jtof-dev/robotics-traveling-van-ipr/documents/RTV_Description.pdf

Project Description: The Robotics Traveling Van project focuses on designing and building two low-cost, portable educational robots that demonstrate core control system concepts for K-12 outreach. Sponsored by Dr. Michael Shafer at Northern Arizona University, the project aims to create safe, highly durable, and visually engaging platforms that help students connect physical robot kinematics to abstract ideas like feedback loops, stability, and actuation. The team is developing two integrated systems: Robot 1, an inverted pendulum robot designed to maintain dynamic balance while students physically interact with it, and Robot 2, a ball-balancing platform that utilizes a center-pivot ball-on-beam architecture. Both robots are engineered specifically for a pilot-run manufacturing scale, ensuring they are classroom-friendly, robust enough to survive repeated physical demonstrations, and visually professional.

Approach: The project utilizes a rigorous engineering design process, translating customer needs into strict engineering requirements through House of Quality matrices, benchmarking, and functional decompositions. To bridge the gap between mechanical hardware and electrical control, the team focused heavily on Design for Manufacturability (DFM) and Design for Assembly (DFA).For Robot 1, the team modeled the inverted pendulum dynamics to design a highly resilient frame capable of surviving classroom drop tests, creating a stable physical baseline for the state space and PID controllers to operate effectively. For Robot 2, the team engineered a center pivot mechanical architecture to minimize rotational inertia, allowing the NEMA 17 stepper motors to react instantaneously to PID feedback. Custom 3D printed PLA and PETG chassis components were developed with integrated mechanical hard stops and protective sensor housings to shield delicate electronics from student handling. Across both platforms, the mechanical infrastructure developed through iterative SolidWorks CAD modeling and high tolerance 3D printing serves as the secure foundation for the electrical team’s sensors, microcontrollers, and real time control algorithms.

Expected Outcomes:
By the culmination of the project, the team will deliver:
- Two Fully Functional Educational Robots: An inverted pendulum and a ball-on-beam system, optimized for immediate deployment in K-12 classrooms.
- Classroom-Ready Mechanical Architecture: Highly robust, portable designs featuring enclosed wiring, heat-set threaded inserts for structural integrity, impact-resistant sensor mounts, and emergency stop capabilities.
- Integrated Control Systems: Active PID feedback controllers that physically demonstrate how sensor measurements and motor torque directly manipulate robot motion in real-time.
- Comprehensive Engineering Documentation: Complete technical data packages including ASME Y14.5 compliant engineering drawings, top-level CAD assemblies, detailed purchasing Bills of Materials (BOM), and classroom curriculum guides.
- A Scalable Manufacturing Plan: A repeatable production framework designed for small-batch manufacturing, ensuring the Robotics Traveling Van fleet can be easily expanded for future NAU outreach programs.

Robot 1- Inverted Pendulum Robot:
Robot 1 is a two-wheeled inverted pendulum designed to demonstrate real-time feedback control and dynamic stability for K–12 STEM outreach. The robot actively balances itself by measuring its tilt angle, computing corrections through a PID controller, and adjusting wheel motion to stay upright. This allows students to interact with the robot physically while observing how control systems respond to disturbances. The mechanical frame was designed for durability and portability, meeting strict safety and impact requirements, including a 30-inch drop test. The system integrates a raspberry-pi controller, dual DC motors with encoders, a magnetic encoder for tilt sensing, a compact chassis with a sleek and structurally stable design, and a touchscreen for user interaction. All components were either purchased from 3rd party distributors or 3D printed to simplify the manufacturing process for mass production and cost reduction. This robot serves as a hands-on demonstration of core engineering concepts, such as system modeling, reactive feedback loops, controller tuning, and how the robot systems and code work in tandem to perform a function. By altering the values in the robot balancing code, students are able to observe in real time how the robot code affects the motors and the pendulums balance, and how small changes in the code can affect the system as a whole.

Robot 2- Ball on Beam Robot:
Robot 2 is a center-pivot ball-on-beam dynamic balancing platform, developed specifically as an educational control-systems demonstrator for the Robotics Traveling Van. The system utilizes precision distance sensing to track ball position along the beam, a NEMA 17 stepper motor to provide instantaneous tilt actuation, and a highly tuned PID controller running on a Raspberry Pi Pico to actively stabilize the system. Mechanically, the platform abandons standard off-center hinges in favor of a custom center-pivot architecture. This vital design choice drastically minimizes rotational inertia, allowing the stepper motor to react to the controller's feedback loop with zero hesitation. To meet the rigorous durability requirements of K-12 classroom environments, the chassis is optimized for small-batch manufacturability (DFM). It features high-tolerance 3D-printed components, heat-set M3 threaded inserts for robust structural rigidity, dedicated protoboard shelving for organized cable management, and protective housings to shield delicate electronics from direct student handling. Educationally, Robot 2 bridges the gap between complex mathematics and physical reality. It allows K–12 students to interactively adjust the balance setpoint via a touchscreen and watch the system's behavior change in real-time. By observing how the ball moves, corrects, and settles on the beam, students gain an intuitive, hands-on understanding of feedback loops and dynamic stability.
