jtof-dev/robotics-traveling-van-ipr/CAD/IPR_CAD_Packet.pdf

16

1927777

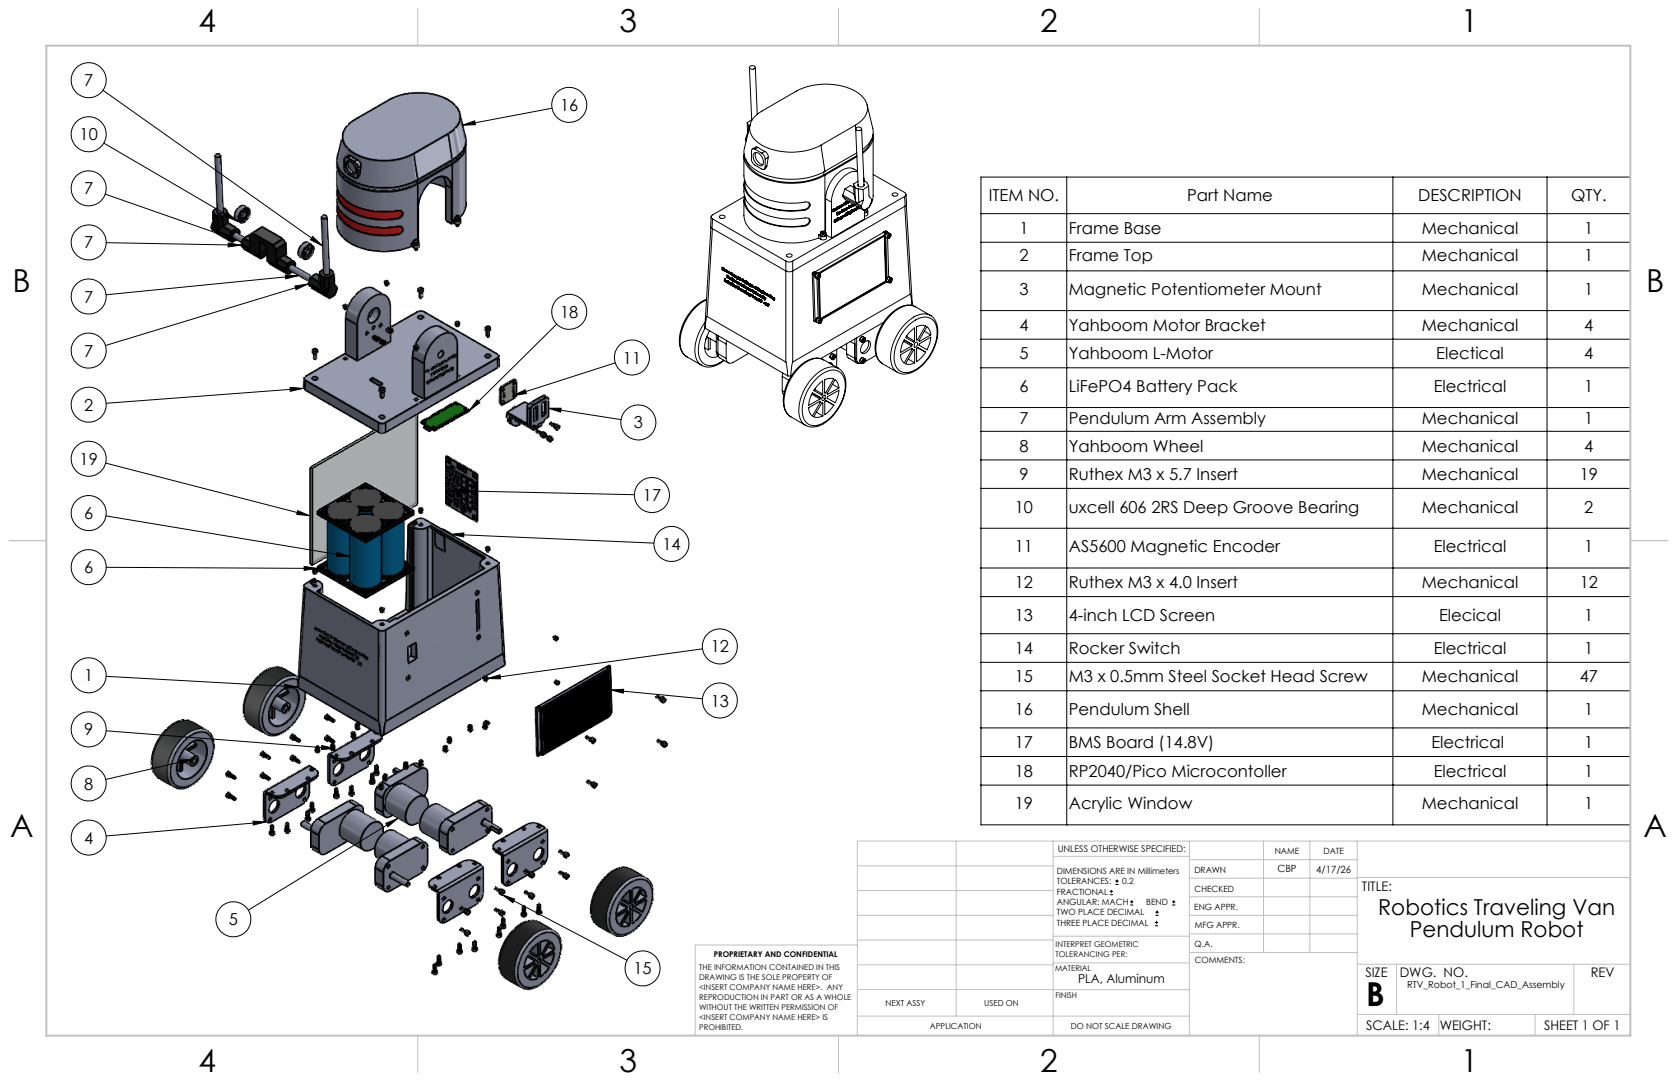
[picture p43: page 1]
ITEM NO.; Part Name; DESCRIPTION; QTY. 1; Frame Base; Mechanical; Frame Top; Magnetic Potentiometer Mount; Yahboom Motor Bracket; Yahboom L-Motor; Electical; LiFePO4 Battery Pack; Electrical; Pendulum Arm Assembly; Yahboom Wheel; Ruthex M3 x 5.7 Insert; COMMENTS:

10 | uxcell 606 2RS Deep Groove Bearing | Mechanical | 2
11 | AS5600 Magnetic Encoder | Electrical | 1
12 | Ruthex M3 x 4.0 Insert | Mechanical | 12
13 | 4-inch LCD Screen | Elecical | 1
14 | Rocker Switch | Electrical | 1
15 | M3 x 0.5mm Steel Socket Head Screw | Mechanical | 47
16 | Pendulum Shell | Mechanical | 1
17 | BMS Board (14.8V) | Electrical | 1
18 | RP2040/Pico Microcontoller | Electrical | 1
19 | Acrylic Window | Mechanical | 1

UNLESS OTHERWISE SPECIFIED: | | NAME | DATE
DIMENSIONS ARE IN Millimeters TOLERANCES: 0.2 FRACTIONAL ANGULAR: MACH BEND TWO PLACE DECIMAL THREE PLACE DECIMAL | DRAWN | CBP | 4/17/26

CHECKED | | | TITLE: Robotics Traveling Van Pendulum Robot

ENG APPR.
MFG APPR.

INTERPRET GEOMETRIC TOLERANCING PER: | Q.A.
MATERIAL PLA, Aluminum | | SIZE B | DWG. NO. RTV_Robot_1_Final_CAD_Assembly | REV

PROPRIETARY AND CONFIDENTIAL
THE INFORMATION CONTAINED IN THIS
DRAWING IS THE SOLE PROPERTY OF
<INSERT COMPANY NAME HERE>. ANY
REPRODUCTION IN PART OR AS A WHOLE
WITHOUT THE WRITTEN PERMISSION OF
<INSERT COMPANY NAME HERE> IS
PROHIBITED.

NEXT ASSY | USED ON | FINISH

APPLICATION | DO NOT SCALE DRAWING | | SCALE: 1:4 | WEIGHT: | SHEET 1 OF 1

# TRUE R5.00

13.13

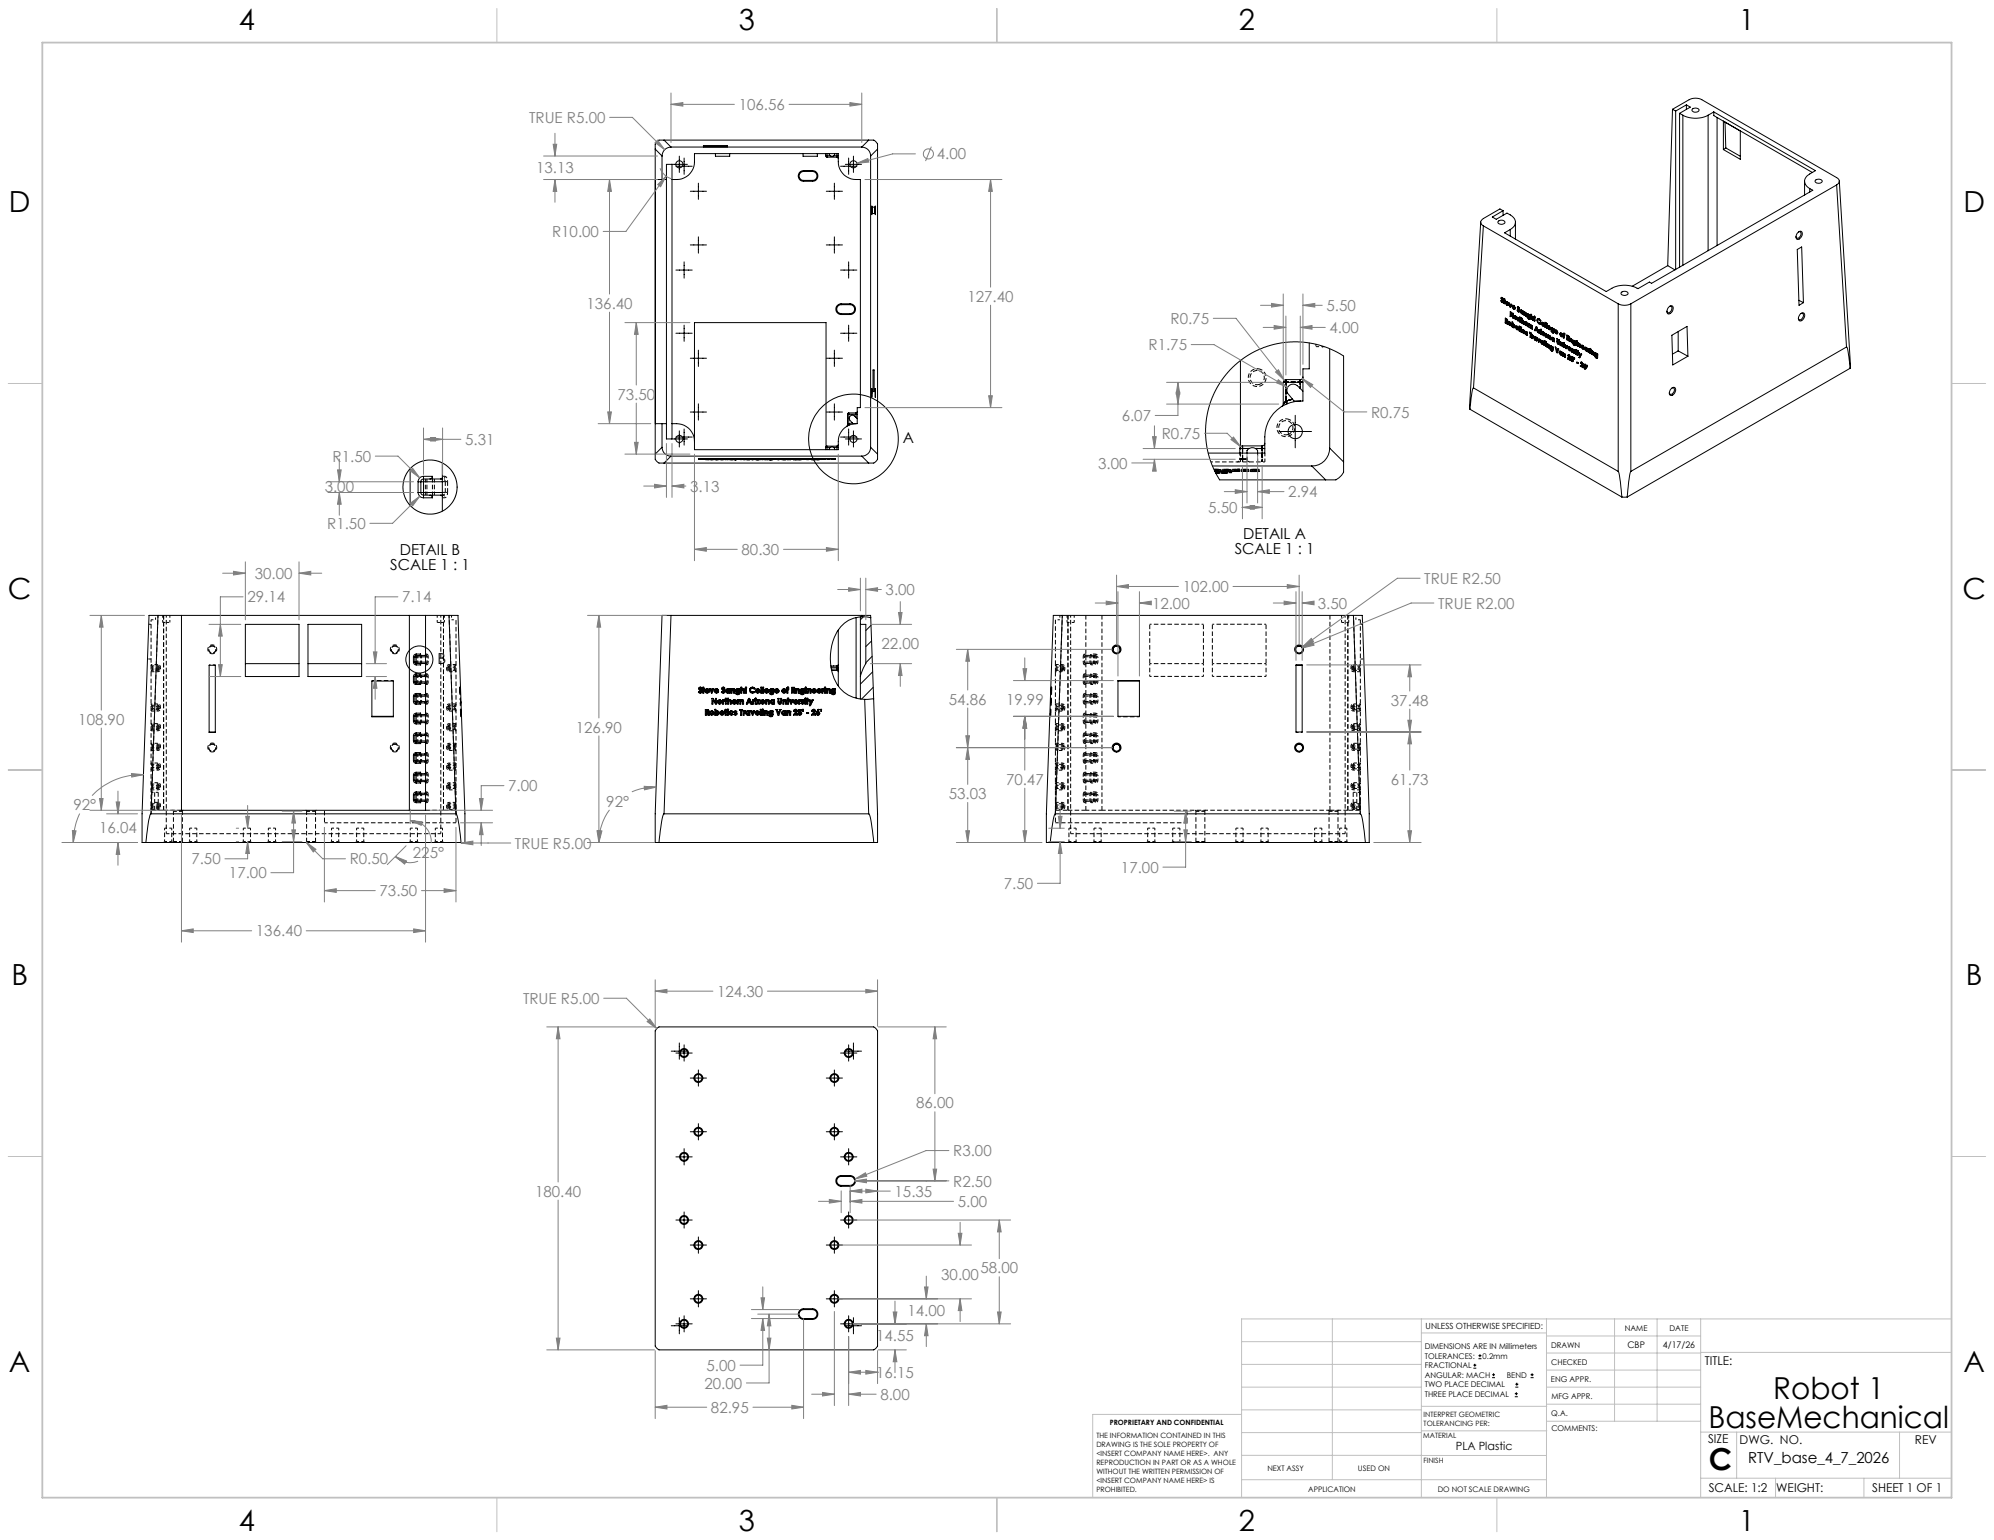
[picture p44: page 2]
TRUE R5.00; TRUE R2.50 TRUE R2.00; 124.30 TRUE R5.00; DETAIL A SCALE 1 : 1; DETAIL B SCALE 1 : 1; PLA Plastic; Robot 1 BaseMechanical; RTV_base_4_7_2026; CBP; SCALE: 1:2 WEIGHT:; DWG. NO.; REV; SIZE; TITLE:; NAME; DATE; COMMENTS:; MFG APPR.; ENG APPR.; CHECKED; DRAWN; FINISH; MATERIAL; INTERPRET GEOMETRIC TOLERANCING PER:; ANGULAR: MACH; BEND; NEXT ASSY; USED ON

UNLESS OTHERWISE SPECIFIED:

DIMENSIONS ARE IN Millimeters
TOLERANCES: 0.2mm
FRACTIONAL
TWO PLACE DECIMAL
THREE PLACE DECIMAL

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

17.00
4.00

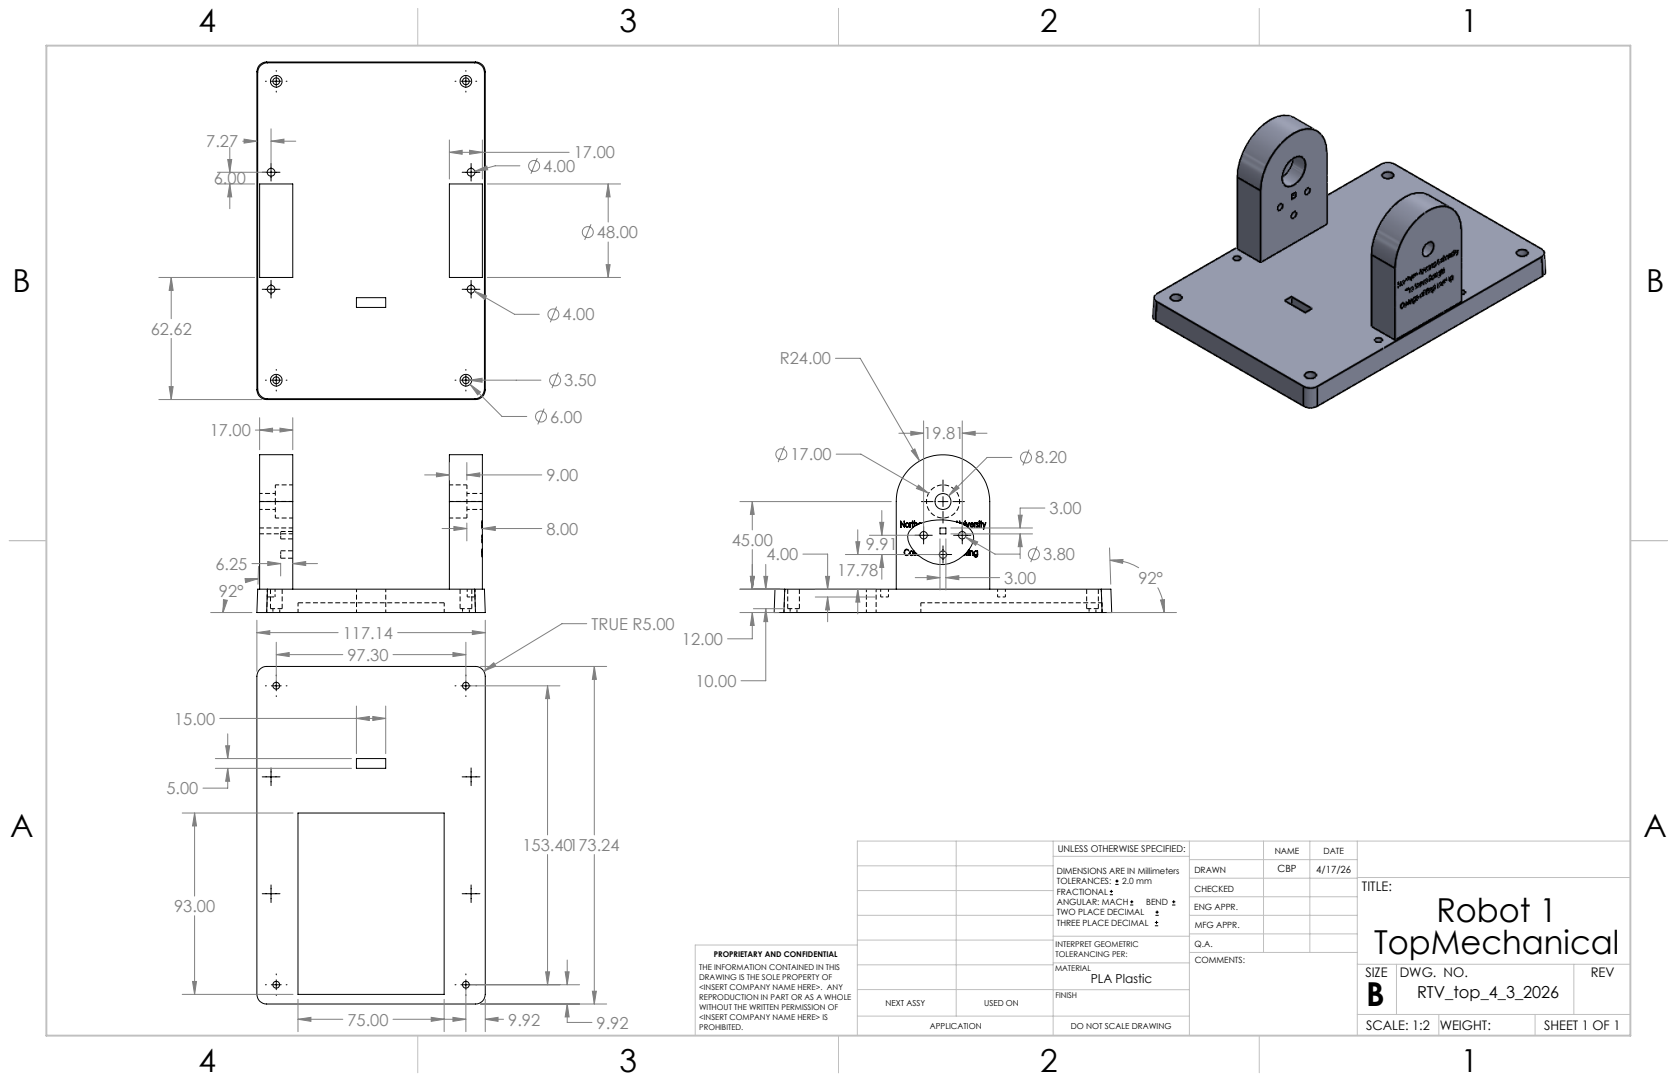
[picture p45: page 3]
TRUE R5.00; COMMENTS:

UNLESS OTHERWISE SPECIFIED: | | NAME | DATE
DIMENSIONS ARE IN Millimeters TOLERANCES: 2.0 mm FRACTIONAL ANGULAR: MACH BEND TWO PLACE DECIMAL THREE PLACE DECIMAL | DRAWN | CBP | 4/17/26

CHECKED | | | TITLE: Robot 1 TopMechanical

ENG APPR.
MFG APPR.

INTERPRET GEOMETRIC TOLERANCING PER: | Q.A.
MATERIAL PLA Plastic | | SIZE B | DWG. NO. RTV_top_4_3_2026 | REV

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

NEXT ASSY | USED ON | FINISH

SCALE: 1:2 | WEIGHT:

R48.65
R42.82

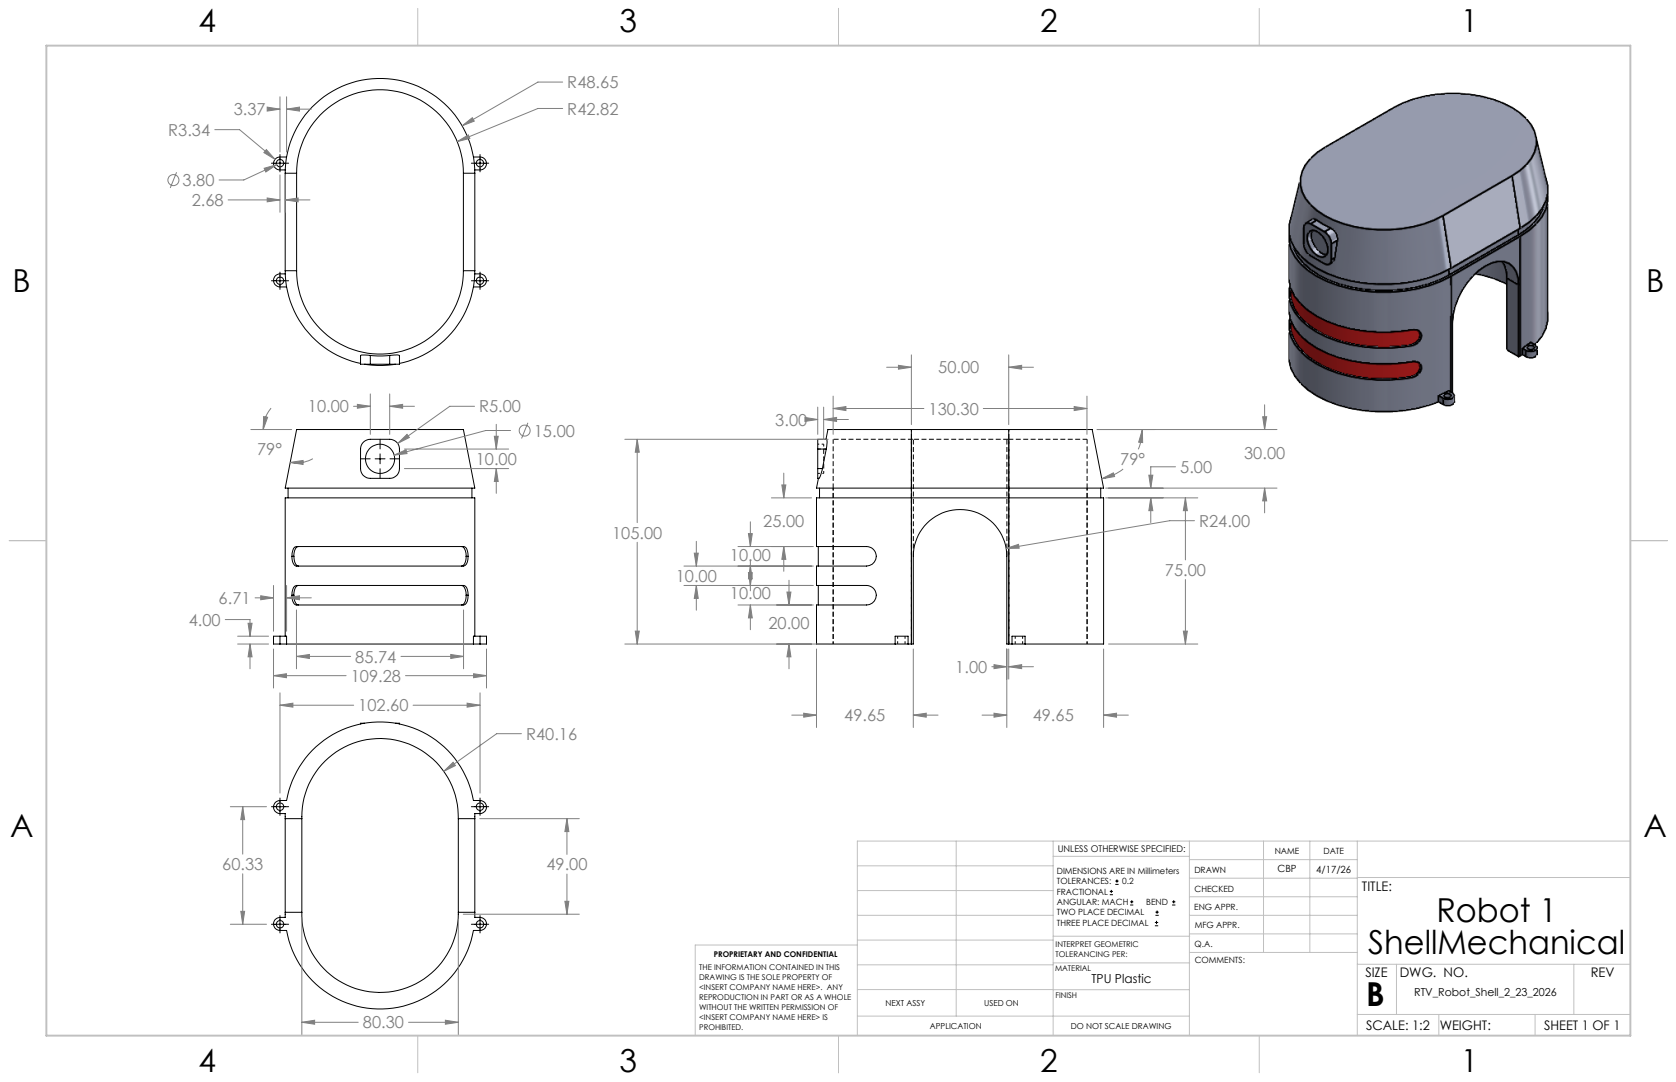
[picture p46: page 4]
COMMENTS:

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

CHECKED | | | TITLE: Robot 1 ShellMechanical

ENG APPR.
MFG APPR.

INTERPRET GEOMETRIC TOLERANCING PER: | Q.A.
MATERIAL TPU Plastic | | SIZE B | DWG. NO. RTV_Robot_Shell_2_23_2026 | REV

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

NEXT ASSY | USED ON | FINISH

SCALE: 1:2 | WEIGHT:

3.25

3.00

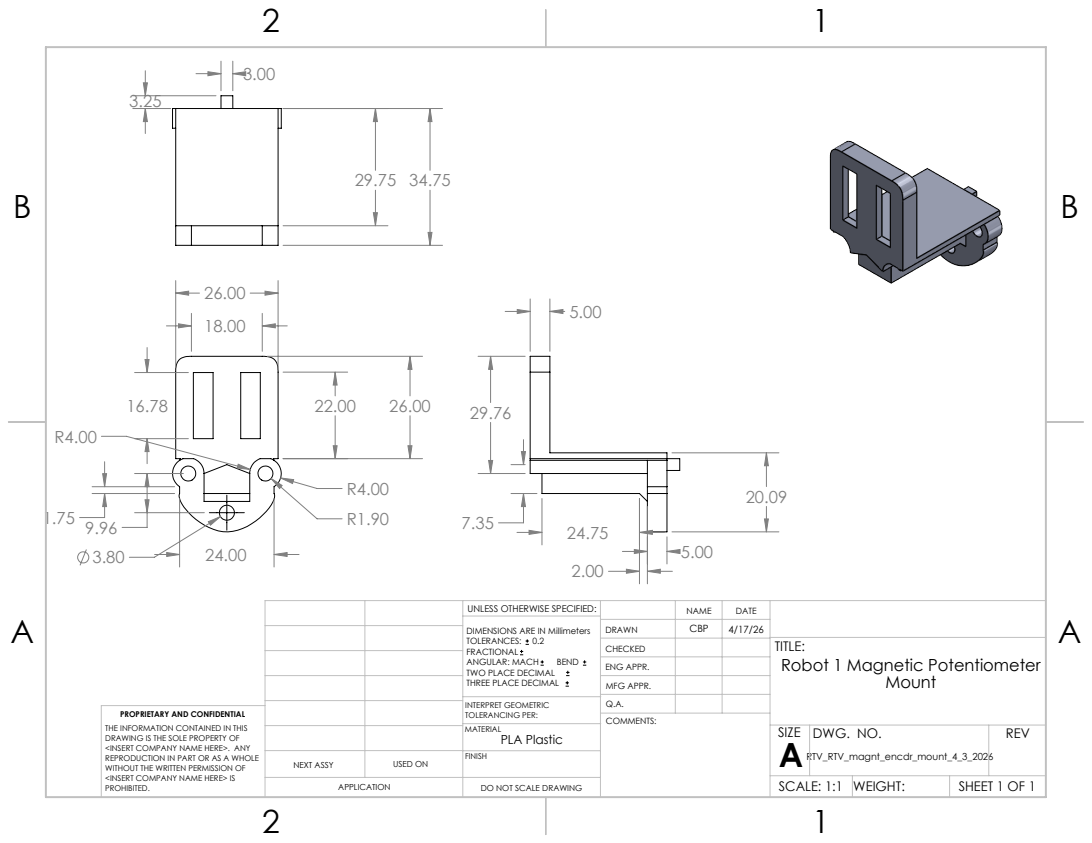
[picture p47: page 5]
COMMENTS:

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

CHECKED | | | TITLE: Robot 1 Magnetic Potentiometer Mount

ENG APPR.
MFG APPR.

INTERPRET GEOMETRIC TOLERANCING PER: | Q.A.
MATERIAL PLA Plastic | | SIZE A RTV_RTV_magnt_encdr_mount_4_3_2026 | DWG. NO. | REV

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

NEXT ASSY | USED ON | FINISH

SCALE: 1:1 | WEIGHT:

3.13
B | B

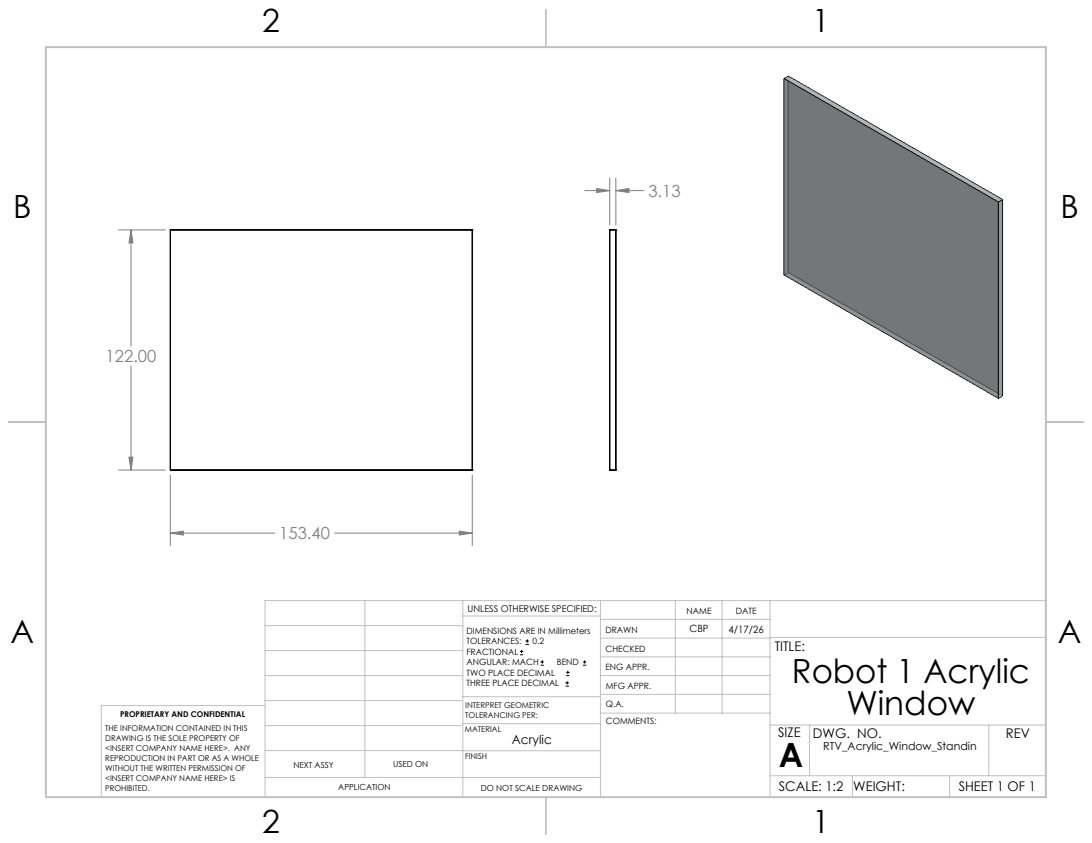
[picture p48: page 6]
COMMENTS:

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

CHECKED | | | TITLE: Robot 1 Acrylic Window

ENG APPR.
MFG APPR.

INTERPRET GEOMETRIC TOLERANCING PER: | Q.A.
MATERIAL Acrylic | | SIZE A | DWG. NO. RTV_Acrylic_Window_Standin | REV

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

NEXT ASSY | USED ON | FINISH

SCALE: 1:2 | WEIGHT:

2
B | B

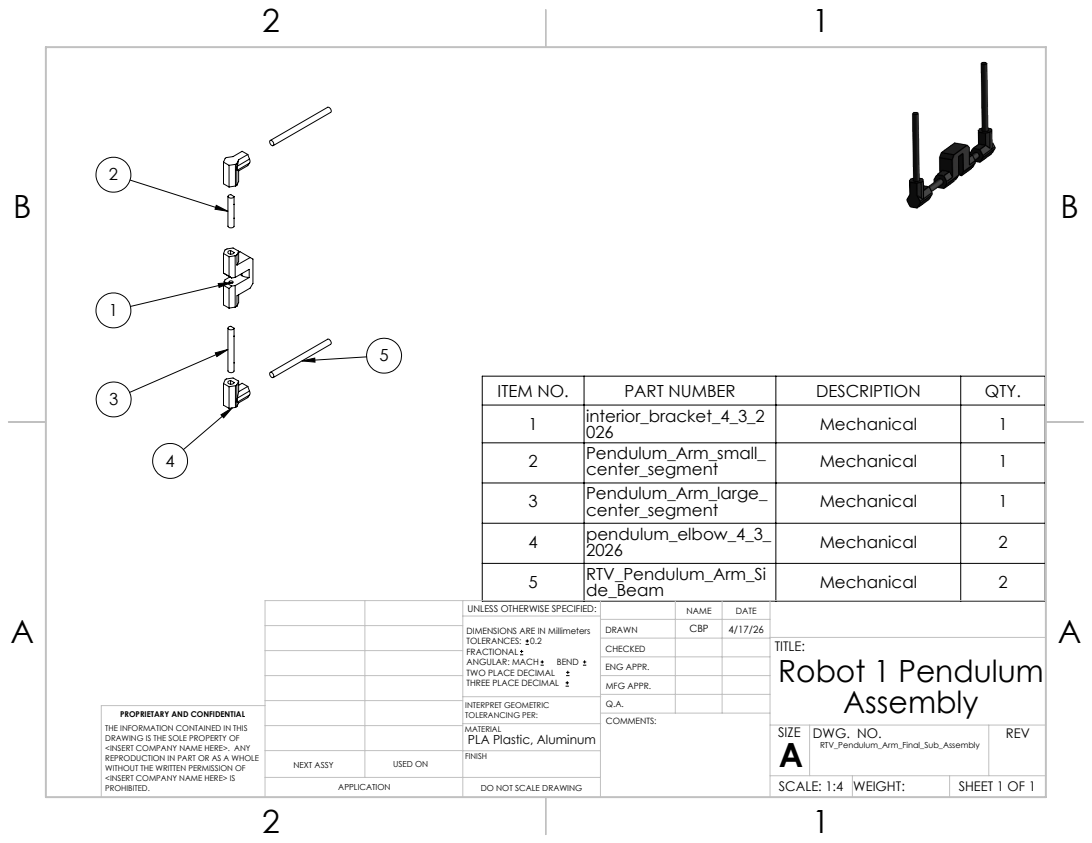
[picture p49: page 7]
COMMENTS:

ITEM NO. | PART NUMBER | DESCRIPTION | QTY.
1 | interior_bracket_4_3_2 026 | Mechanical | 1
2 | Pendulum_Arm_small_ center_segment | Mechanical | 1
3 | Pendulum_Arm_large_ center_segment | Mechanical | 1
4 | pendulum_elbow_4_3_ 2026 | Mechanical | 2
5 | RTV_Pendulum_Arm_Si de_Beam | Mechanical | 2
CHECKED | | | TITLE: Robot 1 Pendulum Assembly

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

ENG APPR.
MFG APPR.

INTERPRET GEOMETRIC TOLERANCING PER: | Q.A.
MATERIAL PLA Plastic, Aluminum | | SIZE A | DWG. NO. RTV_Pendulum_Arm_Final_Sub_Assembly | REV

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

NEXT ASSY | USED ON | FINISH

SCALE: 1:4 | WEIGHT:

18.66

17.50 13.07

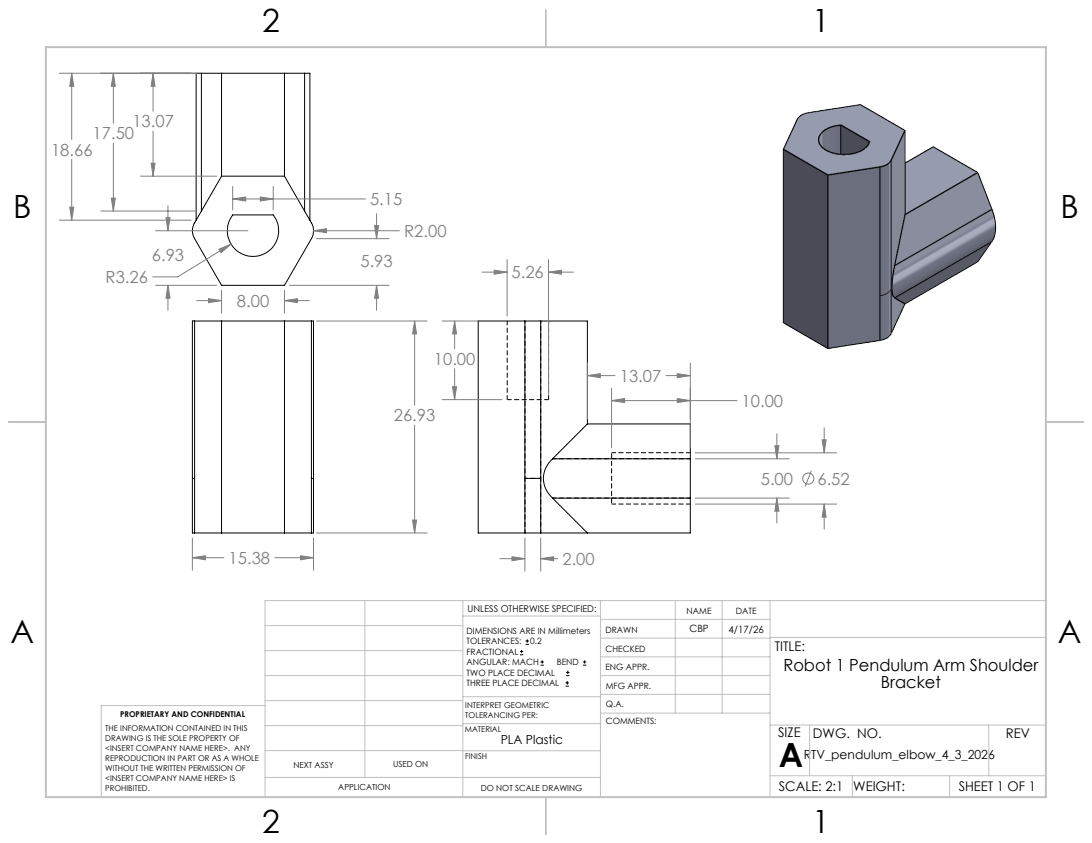
[picture p50: page 8]
COMMENTS:

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

CHECKED | | | TITLE: Robot 1 Pendulum Arm Shoulder Bracket

ENG APPR.
MFG APPR.

INTERPRET GEOMETRIC TOLERANCING PER: | Q.A.
MATERIAL PLA Plastic | | SIZE A RTV_pendulum_elbow_4_3_2026 | DWG. NO. | REV

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

NEXT ASSY | USED ON | FINISH

SCALE: 2:1 | WEIGHT:

5.62

25.56

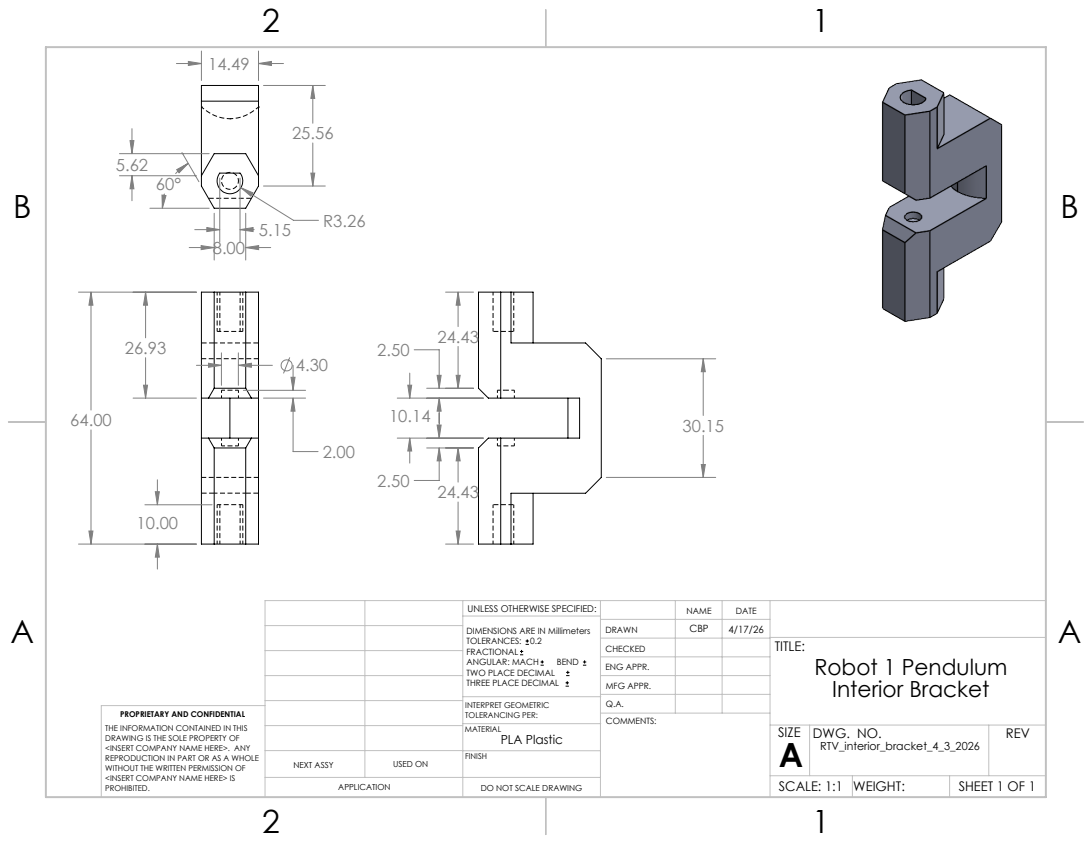
[picture p51: page 9]
COMMENTS:

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

CHECKED | | | TITLE: Robot 1 Pendulum Interior Bracket

ENG APPR.
MFG APPR.

INTERPRET GEOMETRIC TOLERANCING PER: | Q.A.
MATERIAL PLA Plastic | | SIZE A | DWG. NO. RTV_interior_bracket_4_3_2026 | REV

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

NEXT ASSY | USED ON | FINISH

SCALE: 1:1 | WEIGHT:

53.30
B | B

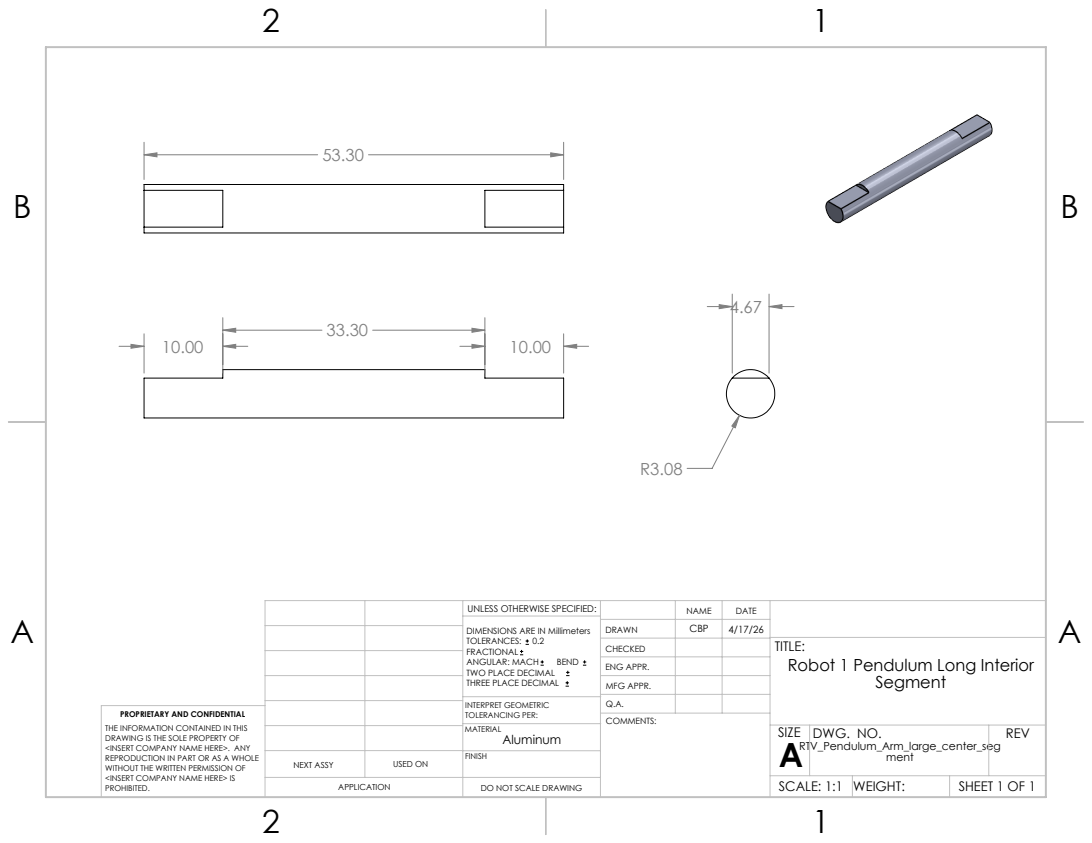
[picture p52: page 10]
COMMENTS:

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

CHECKED | | | TITLE: Robot 1 Pendulum Long Interior Segment

ENG APPR.
MFG APPR.

INTERPRET GEOMETRIC TOLERANCING PER: | Q.A.
MATERIAL Aluminum | | SIZE A RTV_Pendulum_Arm_large_center_seg | DWG. NO. ment | REV

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

NEXT ASSY | USED ON | FINISH

SCALE: 1:1 | WEIGHT:

B | B

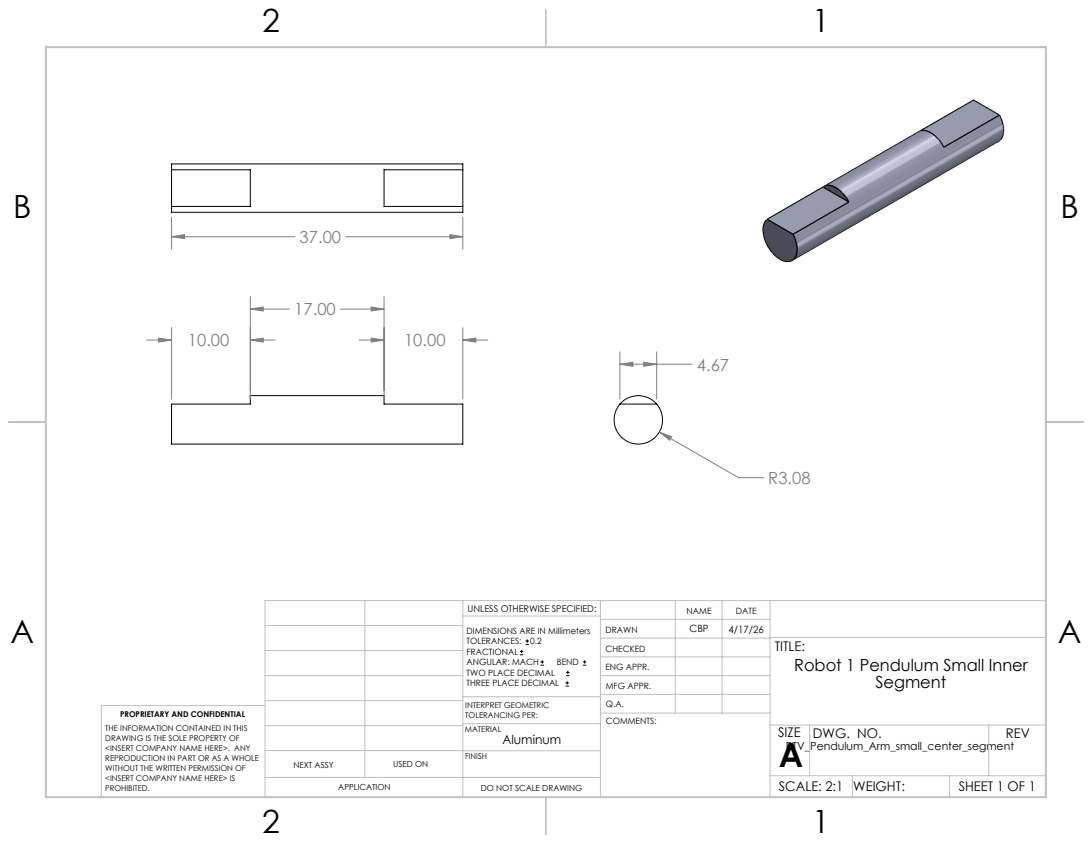
[picture p53: page 11]
COMMENTS:

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

CHECKED | | | TITLE: Robot 1 Pendulum Small Inner Segment

ENG APPR.
MFG APPR.

INTERPRET GEOMETRIC TOLERANCING PER: | Q.A.
MATERIAL Aluminum | | SIZE A RTV_Pendulum_Arm_small_center_segment | DWG. NO. | REV

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

NEXT ASSY | USED ON | FINISH

SCALE: 2:1 | WEIGHT:

B | B

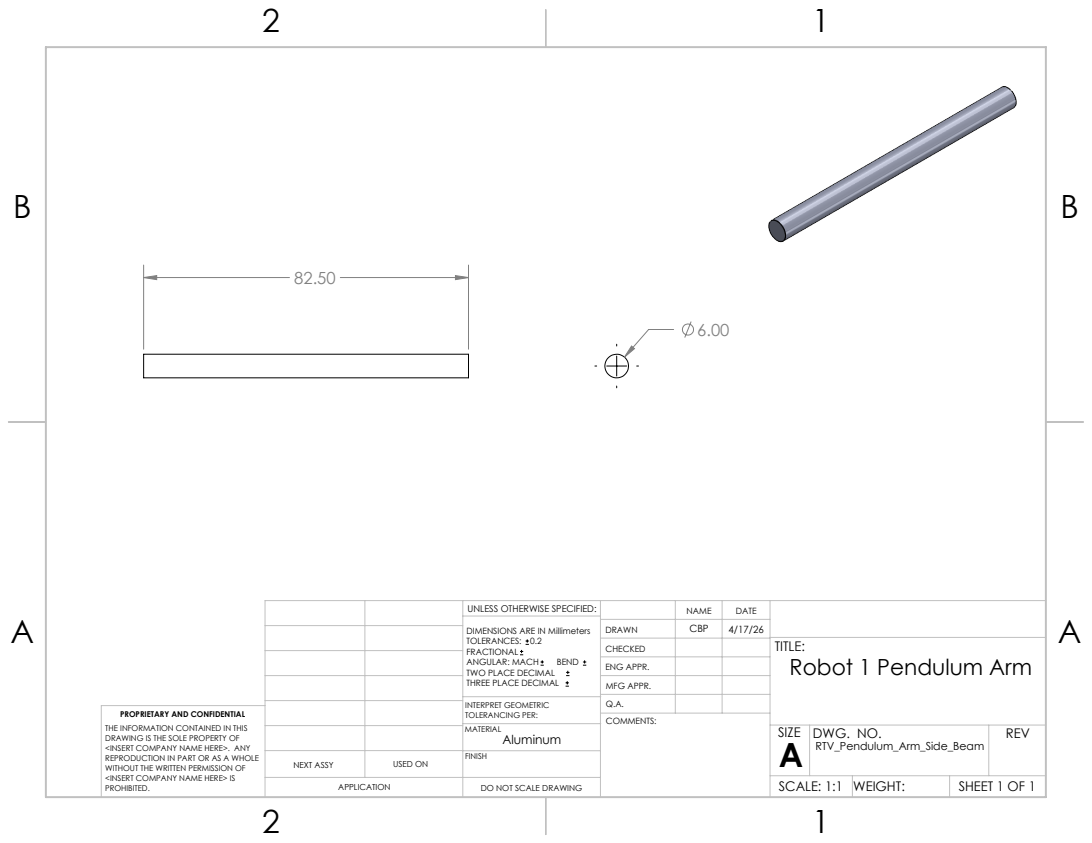
[picture p54: page 12]
COMMENTS:

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

CHECKED | | | TITLE: Robot 1 Pendulum Arm

ENG APPR.
MFG APPR.

INTERPRET GEOMETRIC TOLERANCING PER: | Q.A.
MATERIAL Aluminum | | SIZE A | DWG. NO. RTV_Pendulum_Arm_Side_Beam | REV

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

NEXT ASSY | USED ON | FINISH

SCALE: 1:1 | WEIGHT:

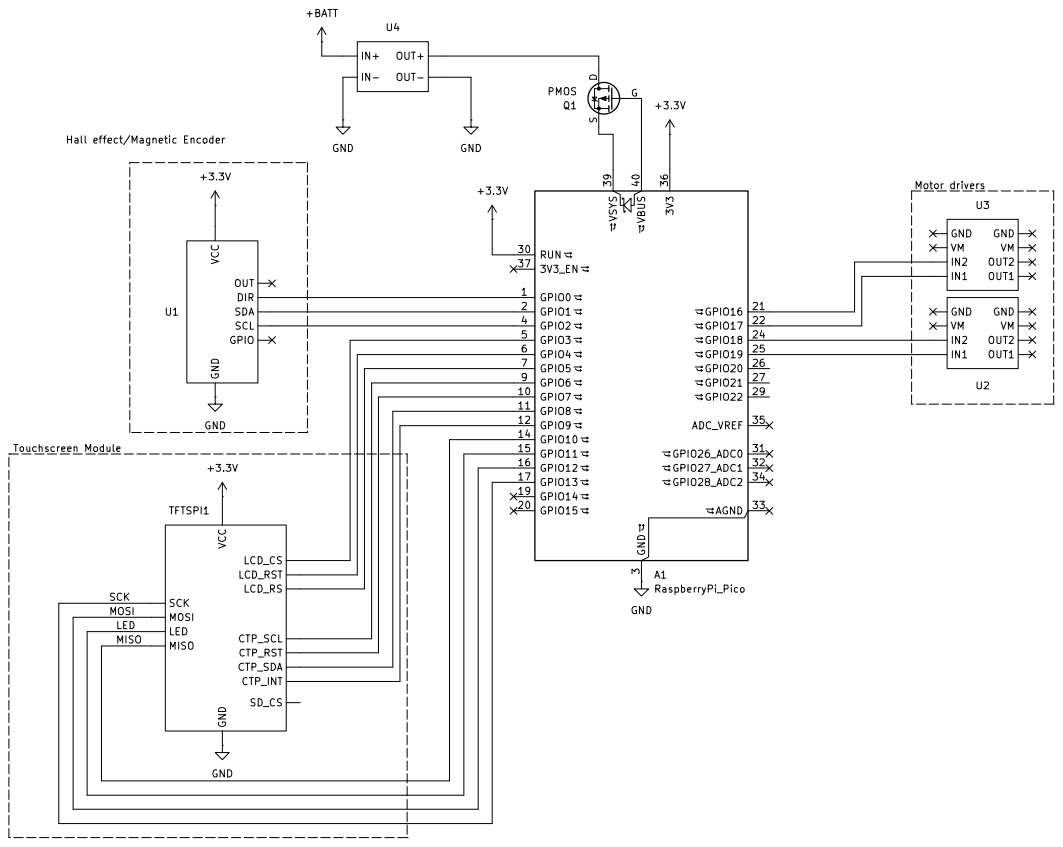
[picture p55: page 13]

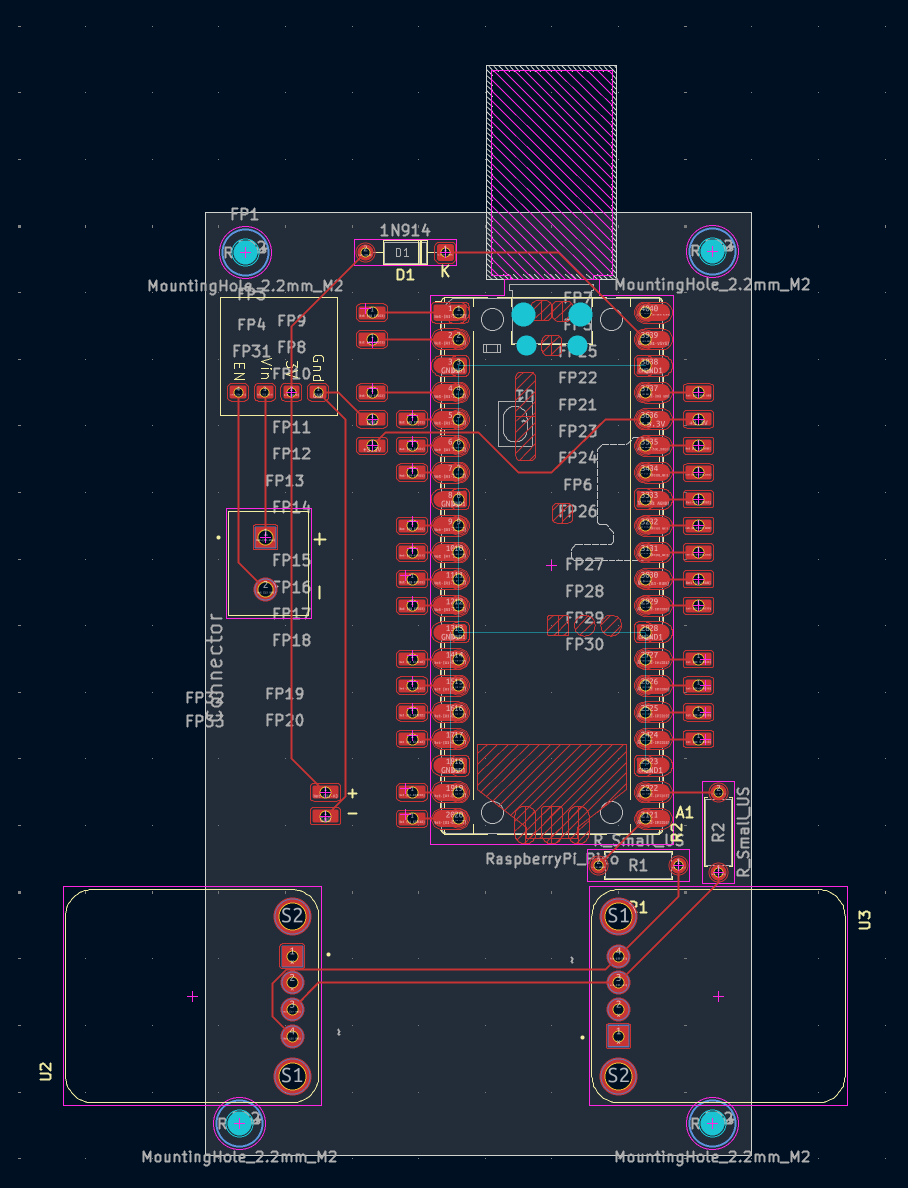
[picture p56: figure]

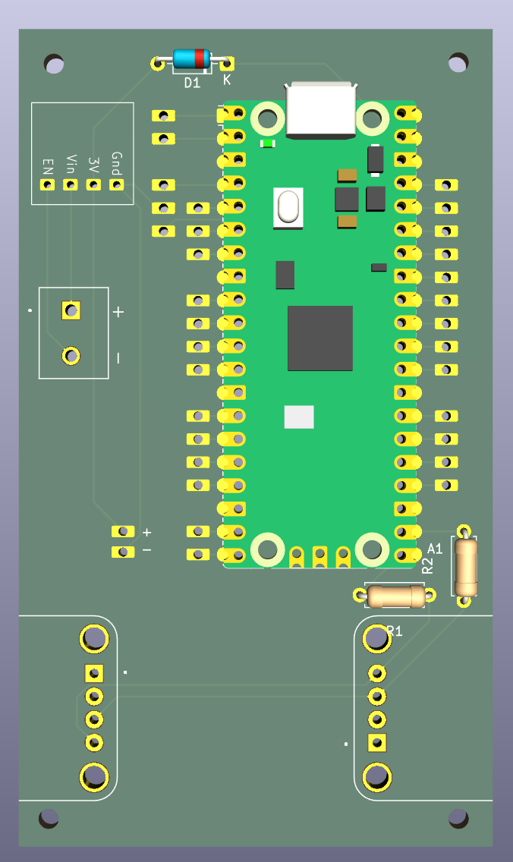
[picture p57: figure]
