jtof-dev/robotics-traveling-van-ipr/PCB/RTV_Robot1_IPR.kicad_pcb

## KiCad design window_motor_unit.kicad_sch


Parts:
C1: 0.47uF/200V
D1: 1.5KE30CA; D_DO-201AE_P15.24mm_Horizontal
K1, K2: JQC-3FF-005-1Z; Relay_SPDT_Hongfa_JQC-3FF_0XX-1Z
M1: DC24V/2A
R1: 24Ω/2W

Connections:
MOTOR_DC24V: K1.14, K2.14
MOTOR_GND: K1.12, K2.12
unnamed: C1.1, D1.1 (A1), K1.11, M1.1 (+)
unnamed: C1.2, R1.1
unnamed: D1.2 (A2), K2.11, M1.2 (-), R1.2
RLY_A: K1.A1
RLY_B: K2.A2
RLY_GND: K1.A2, K2.A1

Notes on the sheet:
M304 RELAY SIDE
MOTOR SIDE
