jtof-dev/robotics-traveling-van-ipr/src/configuration.hpp

#ifndef CONFIGURATION_HPP
#define CONFIGURATION_HPP

// pendulum hardware pins
#define ENCODER_PIN_A 2
#define ENCODER_PIN_B 3

#define MOTOR_IN1 6
#define MOTOR_IN2 7

// main I2C for the AS5600 magnetic encoder
#define I2C_PORT i2c0
#define SDA_PIN 4
#define SCL_PIN 5
#define AS5600_ADDR 0x36

// touch I2C Pins
#define TOUCH_I2C_PORT 1 // set to 0 for I2C0, or 1 for I2C1
#define TOUCH_SDA 26
#define TOUCH_SCL 27
#define TOUCH_RST 10
#define TOUCH_INT 11
#define FT6336U_ADDR 0x38

// pendulum physics & pid math
#define WHEEL_DIAMETER_MM 65.0f
#define WHEEL_CIRCUMFERENCE_MM 204.20f
#define COUNTS_PER_REV 2080.0f
#define MM_PER_COUNT 0.09817f

// defaults (Note: You will likely need to retune these for a speed-based PID)
#define PENDULUM_SETPOINT 88.0f
#define CART_KP 15.0f
#define CART_KI 0.1f
#define CART_KD 0.5f

#define MAX_DISTANCE_MM 304.8f

// treat this as "100% maximum speed" the PID is allowed to ask for.
#define MAX_SPEED 100.0f

// 100 (Max Speed) * 2.55 = 255 (Max 8-bit PWM)
// this cleanly maps your 0-100 speed scale to the hardware limit
#define SPEED_TO_PWM_RATIO 2.55f

#define MOTOR_DEADBAND 70.0f

#define CMD_UPDATE_KP 0x01
#define CMD_UPDATE_KI 0x02
#define CMD_UPDATE_KD 0x03

#endif
