jtof-dev/robotics-traveling-van-ipr/(commit log)

2026-02-02 feat: switch to using submodules
2026-02-03 feat: update pins and add pin notes
2026-03-28 feat: add untested force PID code
2026-03-31 feat: re-add dir pin
2026-04-03 feat: update flowchart
2026-04-03 fix flowchart
2026-04-10 feat: add circuit diagram
2026-04-16 breaking feat: rewrite to use `arduino-cli` and implement a basic touchscreen
2026-04-17 perhaps fix some issues. moves MISO pin to GP0
    [configuration.hpp, src.ino]
2026-04-24 feat: add CAD models and PCBs and some documents
2026-05-02 feat: update pcb files
    [RTV_Robot1_IPR.kicad_pcb, RTV_Robot1_IPR.kicad_sch]
